MindGas/Heating_System/README.md

# XBee Heating System for Home Assistant
 ZigBee-Arduino heating system controls for Home Assistant with ZHA integration.
 
 This was deployed for 4 years and counting. Solid solution with no issues for central home and hot water heating system. Two thermometers are used to check hot water boiler temperature at high and low points and send this information to Home Assistant over the ZigBee network. This temperature information then can be used in automations or creating new sensors. Another functionality is to turn on/off the electric water heater and central gas heating with two relays. Previously I have implemented this with different radios. Changing to ZigBee protocol to improve reliability and lessen maintenance by getting rid of another integration.  
 
 For prototyping/debugging setup nano needs to be flashed with /DebugDeviceCode/SoftwareSerialExample.ino sketch.
 
 Forked/reworked from [GitHub Gist prairiesnpr/water_heater.ino](https://gist.github.com/prairiesnpr/7a40b78e765044252a4799d328327f0a)
 
 ## Known Issues and Work List
 - [x] ~~Sending Endpoint temperature values fails with code 21 = Network ACK failure.~~ (Fixed)
 - [x] ~~On/Off switch endpoint not tested, presuming not functioning.~~ (Implemented and tested)
 - [x] ~~Improve initialization (pairing) logic. Basic Cluster attribute sent twice.~~ (Got rid of the loop)
 - [x] ~~Relay safety feature. Turn off relays if no status update within 1 minute.~~ (timer checks if relay status was received every 1 min)
 - [x] ~~3 on/off endpoints shows up in Home Assistant while only 2 defined.~~ (wrong number of clusters were defined for some of the EPs)
 - [x] ~~Clean up code~~
 - [x] ~~Added status LEDs. One for Power On, two for both relay on/off status.~~
 - [x] So far so good. Testing in production mode. 4 Years without issues
 
 ## Hardware:
  Prototyping:
 * Digi XBee S2C (XB24C)
 * Waveshare XBee USB adapter
 * Arduino Uno R3
 * Arduino Nano
 * Tempereture Sensor DS18B20 x2
 * Resistor 4.7kΩ
 * Relay x2

 Prototyping / Debugging Setup:
 
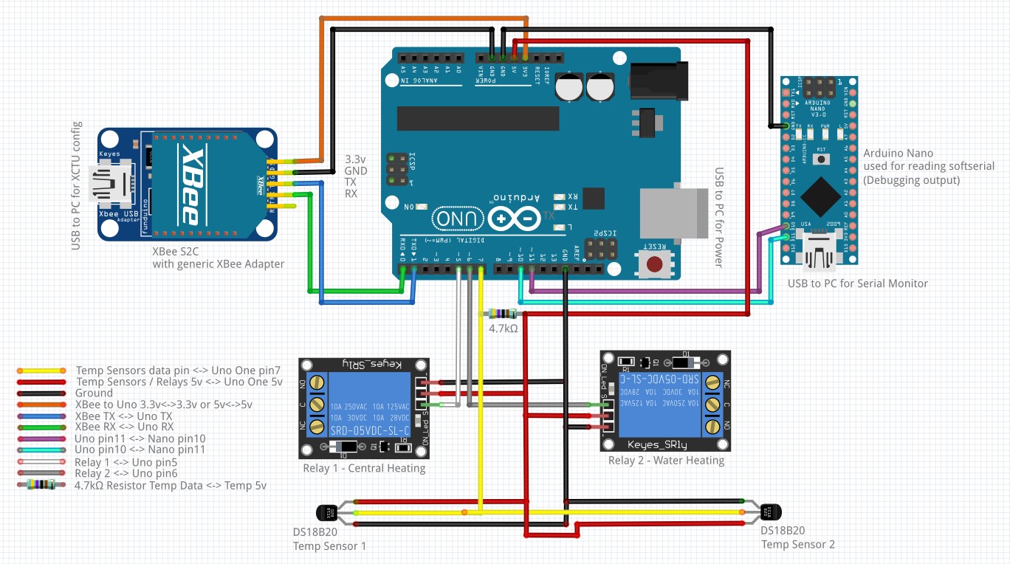
[picture p1: images/XBee_Heating_System_Prototyping.jpg]
Protopyping setup


  Production:
 * Digi XBee S2C (XB24C)
 * Nano IO shield
 * Arduino Nano
 * Tempereture Sensor DS18B20 x2
 * Resistor 4.7kΩ
 * Resistor 22kΩ x3
 * LED x3
 * Relay x2
 * 12V Power Supply

 Production Setup:
 
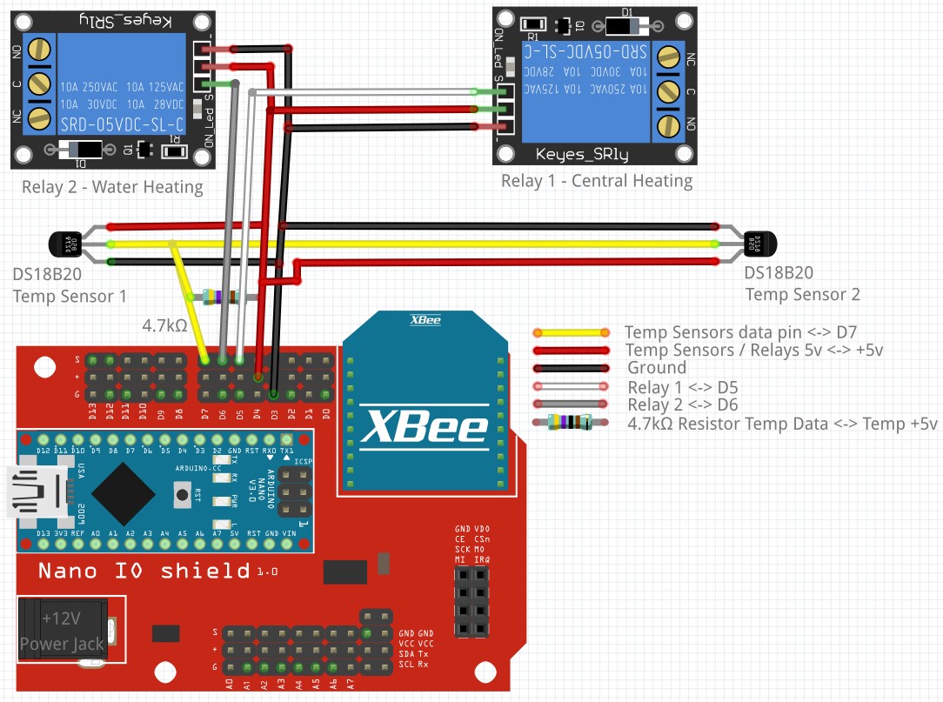
[picture p2: images/XBee_Heating_System_Production.jpg]
Production setup

 
 ## XBee Parameters
 XBee needs to be configured before it can be used. Use Digi XCTU software to configure it. Not all parameters below are required and some could have other values, but this works for me. Parameters in bold are required with suggested values.
 * **ZS 2**
 * NJ 5A
 * NI heating
 * **EE 1**
 * **EO 1**
 * **KY 5a6967426565416c6c69616e63653039**
 * D7 0
 * **AP 2**
 * **AO 3**
 * P0 5
 * IR 1388
 * IC FFFF
 
 ## Screenshots
 Home Assistant with ZHA integration establishes a connection with XBee-Arduino device ower ZigBee protocol
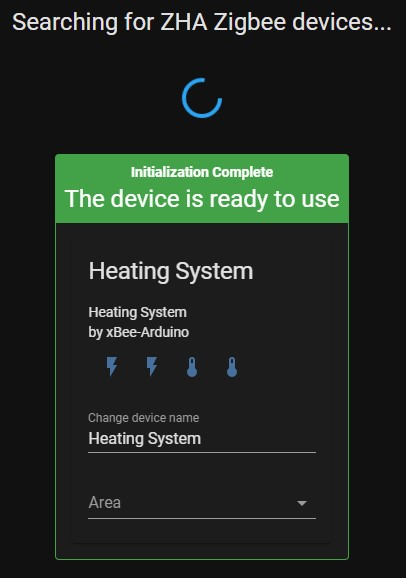
[picture p3: images/ZHA-ZigBee_device_added.jpg]
Home Assistant - ZHA


Debugging output in Arduino Serial Monitor
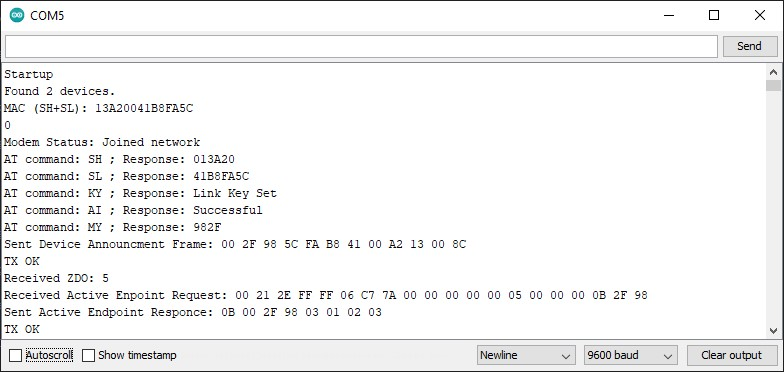
[picture p4: images/SerialMonitor-DebuggingInfo.jpg]
Serial Monitor

 
 ## Good To Know
 * Disconnect TX/RX lines between XBee and Uno when uploading sketch
 * If using Arduino Serial Monitor don't forget to switch port to Nano port after uploading sketch to Uno.
 * Disconnect TX/RX lines between XBee and Uno when configuring XBee over XCTU
 
 ## Would Not Be Possible Without
 [GitHub Gist prairiesnpr/water_heater.ino](https://gist.github.com/prairiesnpr/7a40b78e765044252a4799d328327f0a)
 
 [Blog "Connecting an Xbee 24ZB to Smartthings Hub" by George](https://nzfalco.jimdofree.com/electronic-projects/xbee-to-smartthings/)
 
 [XBee-Arduino library by andrewrapp](https://github.com/andrewrapp/xbee-arduino)
  
 [Digi XBee/XBee-PRO® S2C Zigbee® RF Module manual](https://www.digi.com/resources/documentation/Digidocs/90002002/Default.htm)
 
 [ZigBee Alliance - ZigBee Specification document](https://zigbeealliance.org/wp-content/uploads/2019/12/docs-05-3474-21-0csg-zigbee-specification.pdf)

 [ZigBee Alliance - ZigBee Cluster Library Specification document](https://zigbeealliance.org/wp-content/uploads/2019/12/07-5123-06-zigbee-cluster-library-specification.pdf)
