MindGas/Heating_System/(threads)

Thread 1 (2024-05-09):

Unable to pair

Rob190, 2024-05-09:
Doesn't appear to work with ZHA/Sonoff USB. The Xbee is detected in HA and starts the 'interview', but is unable to complete the discovery process. Unsure how to proceed.

```
���SoftwareSerial Read Started on debug serial read device!

�
### Starting up XBee-Arduino ###
  Starting temperature device search
  Found 2 temperature sensors.

### Starting up XBee-Arduino ###
  Starting temperature device search
  Found 2 temperature sensors.
  MAC (SH+SL): FFFFFFFFFFFFFFFF
!! Read Temp for EP3: 25.31°C
<- Sent Attribute Report: 00 00 0A 00 00 21 E3 09
     cluster_id: 402
     attr->id: 0
     attr->type: 21
     attr->val_len: 2
     attr->value: 00 00
     src_ep: 3
     dst_ep: 1
!! Read Temp for EP4: 25.31°C
<- Sent Attribute Report: 00 00 0A 00 00 21 E3 09
     cluster_id: 402
     attr->id: 0
     attr->type: 21
     attr->val_len: 2
     attr->value: 00 00
     src_ep: 4
     dst_ep: 1
!! Read Temp for EP3: 25.31°C
<- Sent Attribute Report: 00 00 0A 00 00 21 E3 09
     cluster_id: 402
     attr->id: 0
     attr->type: 21
     attr->val_len: 2
     attr->value: 00 00
     src_ep: 3
     dst_ep: 1
!! Read Temp for EP4: 25.31°C
<- Sent Attribute Report: 00 00 0A 00 00 21 E3 09
     cluster_id: 402
     attr->id: 0
     attr->type: 21
     attr->val_len: 2
     attr->value: 00 00
     src_ep: 4
     dst_ep: 1
!! Central Heating Relay Status NOT Received Witin Time!!!
     Shutting Down Relay!!!
!! Water Heating Relay Status NOT Received Witin Time!!!
     Shutting Down Relay!!!
```

Rob190, 2024-05-18:
After some investigation, it appears that the ATMega328 has insufficent RAM for this to work, and adding extra debug code only made the situation worse. I've been able to get it to run on an ATMega2560

Closed 2024-05-18.
