MindGas/Heating_System/(commit log)

2021-10-04 Temp and relays implemented
    Temperature updated on HA side every 30 seconds or when requested.
    Relays turn on/off when requested from HA.
2021-10-16 relay status safety and some bugs
    [Heating_System.ino, declare.h, functions.h, response.h, send.h]
2021-10-21 Productive release
    Added status LEDs
    Some code cleanup
    Added PRD setup
